bml3mk5/L3KanjiRom/README.md

# Kanji ROM Card for HITACHI BASIC MASTER LEVEL3

This is my original Kanji ROM Card for HITACHI BASIC MASTER LEVEL3.

## Used Tools

* KiCAD Version 5
