bml3mk5/L3KanjiRom/NEW_KANJI_ROM.kicad_pcb

## KiCad design NEW_KANJI_ROM.kicad_pcb (2023-03-06)

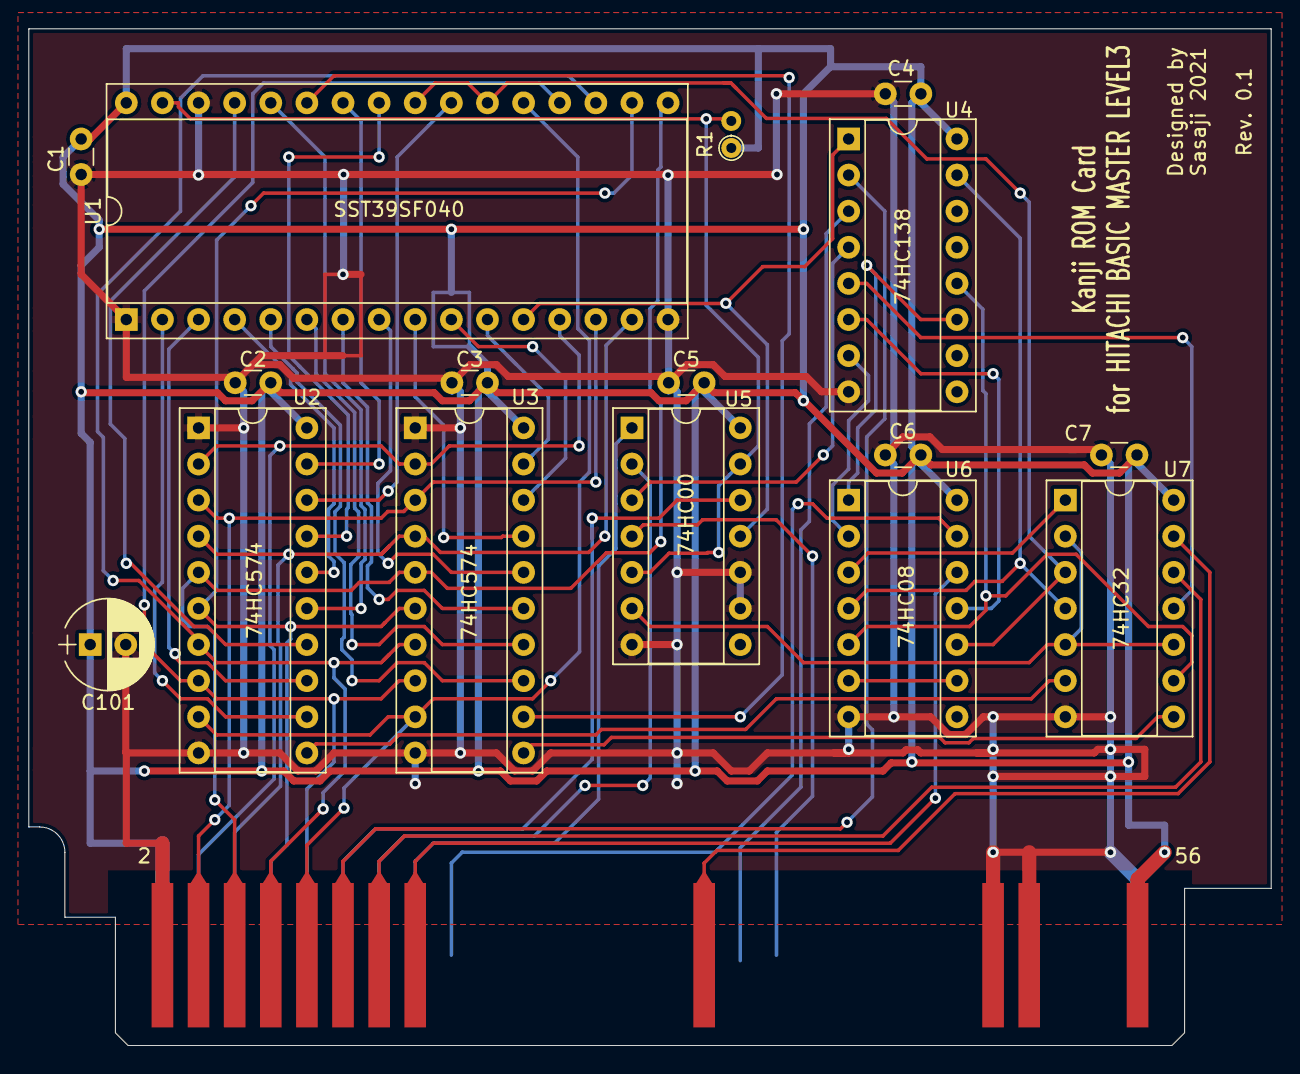
[picture p2: board NEW_KANJI_ROM.kicad_pcb from above]

Board: 2 copper layers, 87.4 x 71.5 mm, 17 parts (0 on the bottom side), 51 nets.

Parts:
C1, C2, C3, C4, C5, C6, C7: 0.1u; C_Disc_D3.0mm_W1.6mm_P2.50mm
C101: 100u; CP_Radial_D6.3mm_P2.50mm
J1: Conn_02x28_Odd_Even; CardEdge56
R1: 4.7K; R_Axial_DIN0204_L3.6mm_D1.6mm_P1.90mm_Vertical
U1: SST39SF040; DIP-32_W15.24mm_Socket
U2, U3: 74HC574; DIP-20_W7.62mm_Socket
U4: 74HC138; DIP-16_W7.62mm_Socket
U5: 74HC00; DIP-14_W7.62mm_Socket
U6: 74HC08; DIP-14_W7.62mm_Socket
U7: 74HC32; DIP-14_W7.62mm_Socket

Connections:
/A0: J1.11, U5.12
/A1: J1.12, U4.2
/A2: J1.13, U5.2
/A3: J1.14, U7.12
/A4: J1.15, U5.1
/A5: J1.16, U6.12
/A5_A6: U4.6, U6.11
/A6: J1.17, U6.13
/BA1: U1.11, U3.19
/BA2: U1.10, U3.18
/BA3: U1.9, U3.17
/BA4: U1.8, U3.16
/BA5: U1.7, U3.15
/BA6: U1.6, U3.14
/BA7: U1.5, U3.13
/BA8: U1.27, U3.12
/BA9: U1.26, U2.19
/BA10: U1.23, U2.18
/BA11: U1.25, U2.17
/BA12: U1.4, U2.16
/BA13: U1.28, U2.15
/BA14: U1.29, U2.14
/BA15: U1.3, U2.13
/BA16: U1.2, U2.12
/BD0: J1.3, U1.13, U2.2, U3.2
/BD1: J1.4, U1.14, U2.3, U3.3
/BD2: J1.5, U1.15, U2.4, U3.4
/BD3: J1.6, U1.17, U2.5, U3.5
/BD4: J1.7, U1.18, U2.6, U3.6
/BD5: J1.8, U1.19, U2.7, U3.7
/BD6: J1.9, U1.20, U2.8, U3.8
/BD7: J1.10, U1.21, U2.9, U3.9
/E: J1.35, U5.4
/R~W: J1.33, U4.3
/~A2_A4: U4.4, U5.3
/~AA0: U1.12, U4.1, U5.11
/~ASEL3: U4.5, U7.11
/~BE: U5.6, U7.2, U7.5, U7.10
/~DATA_W: U6.6, U6.9
/~EX_IO: J1.32, U7.13
/~FF75_76_R: U6.3, U7.1
/~FF75_76_RE: U1.22, U1.24, U6.10, U7.3
/~FF75_R: U4.11, U6.1
/~FF75_W: U4.15, U6.4, U7.4
/~FF75_WE: U2.11, U7.6
/~FF76_R: U4.7, U6.2
/~FF76_W: U4.12, U6.5, U7.9
/~FF76_WE: U3.11, U7.8
GND: C1.2, C2.2, C3.2, C4.2, C5.2, C6.2, C7.2, C101.2, J1.2, J1.48, J1.50, J1.55, U1.1, U1.16, U1.30, U2.1, U2.10, U3.1, U3.10, U4.8, U5.7, U5.9, U5.10, U6.7, U7.7
PUR1: R1.2, U1.31, U5.5, U5.13
VCC: C1.1, C2.1, C3.1, C4.1, C5.1, C6.1, C7.1, C101.1, J1.1, J1.56, R1.1, U1.32, U2.20, U3.20, U4.16, U5.14, U6.14, U7.14
